Alan-Baylis/robot-electronics/README.md

# robot-electronics
Boards, schematics, reference docs, etc
