Alan-Baylis/robot-electronics/gripper/NOTES.MD

Files in this repo:
* GripperController.dch = DipTrace schematic for GripperController PCB
* GripperController.pdf = PDF of schematic
* GripperController.dip = DipTrace PCB layout file
* GripperControllerBoM.csv = Bill of Materials for GripperController PCB
* GripperController.ino = Arduino source code for GripperController firmware
* HerkulexT.cpp, HerkulexT.h = Arduino library for Herkulex servo, customized (place in same directory as .ino file)
