Alan-Baylis/robot-electronics/System Diagram 003.pdf

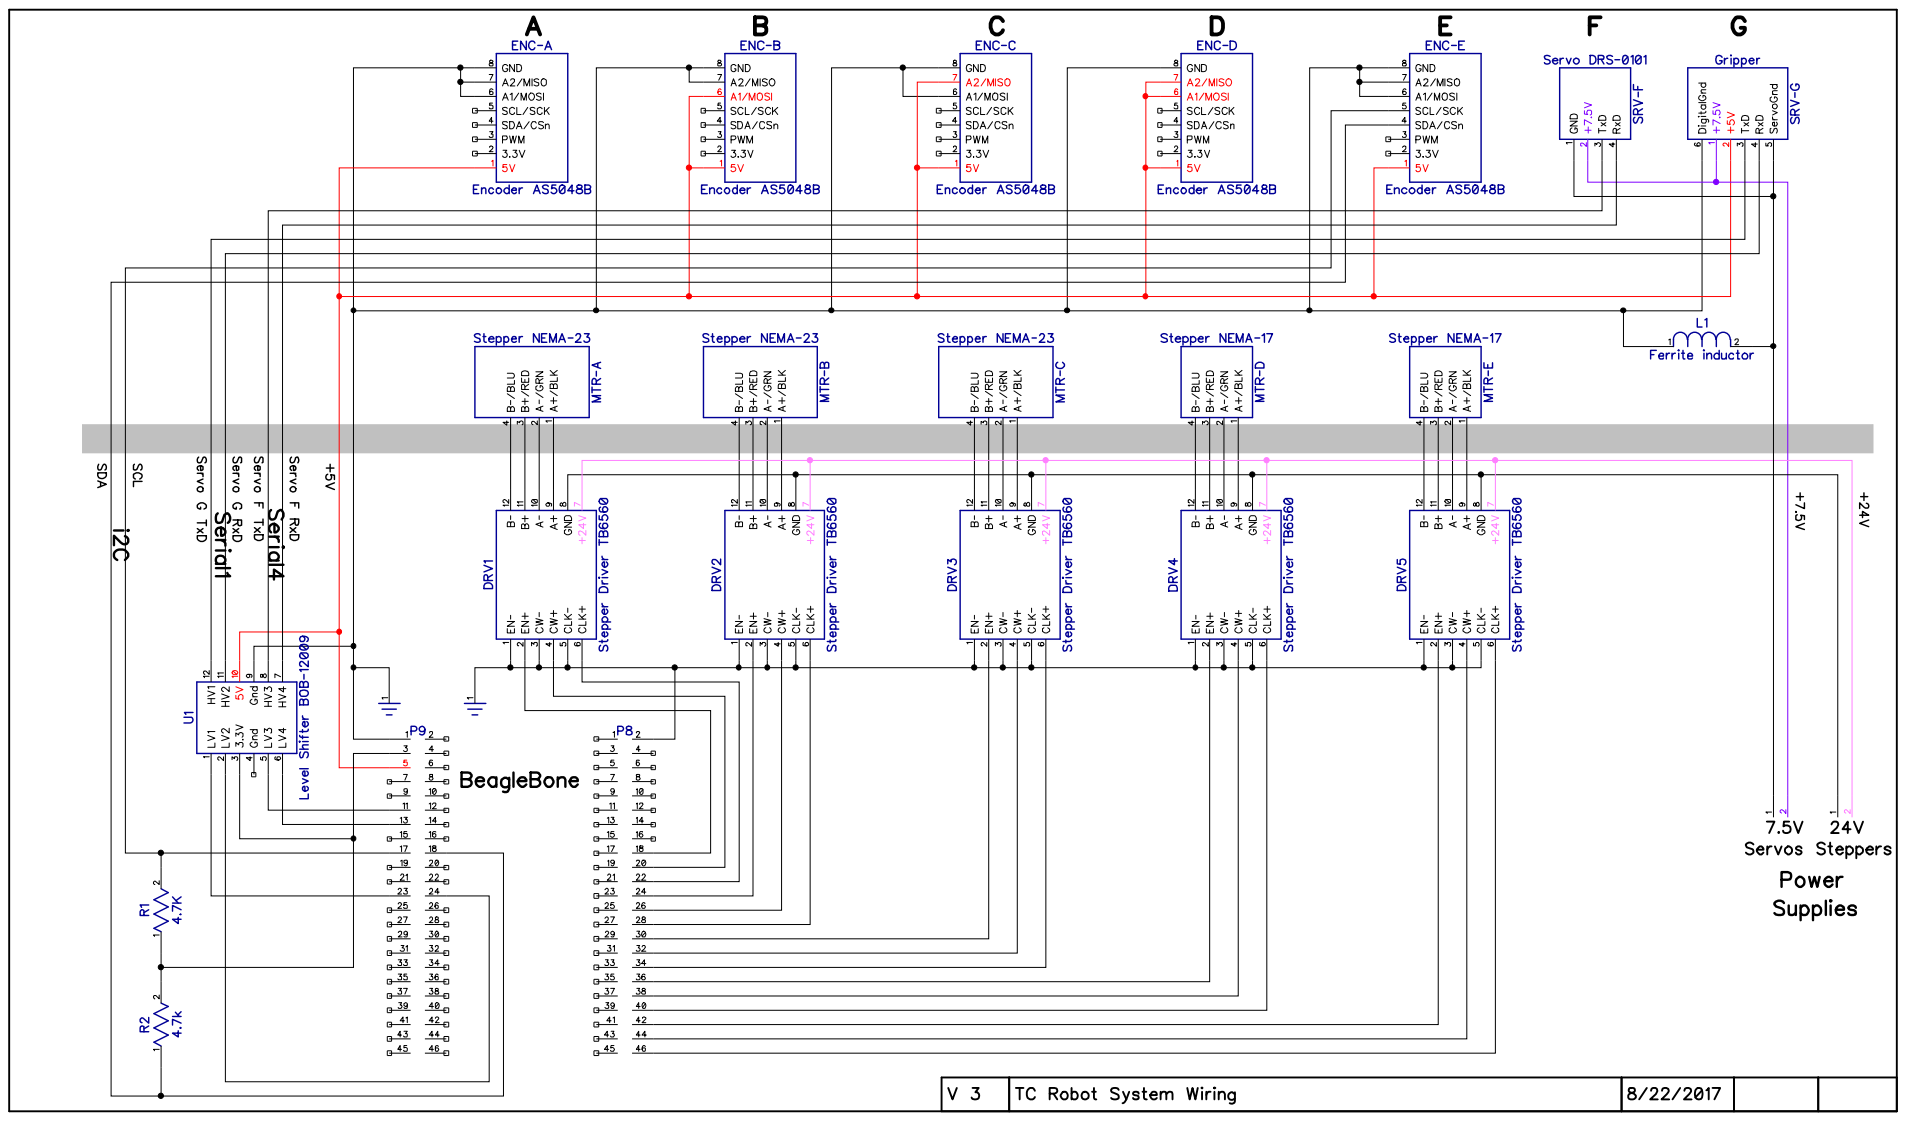
[picture p1: page 1]
