Alan-Baylis/robot-electronics/gripper/GripperController.pdf

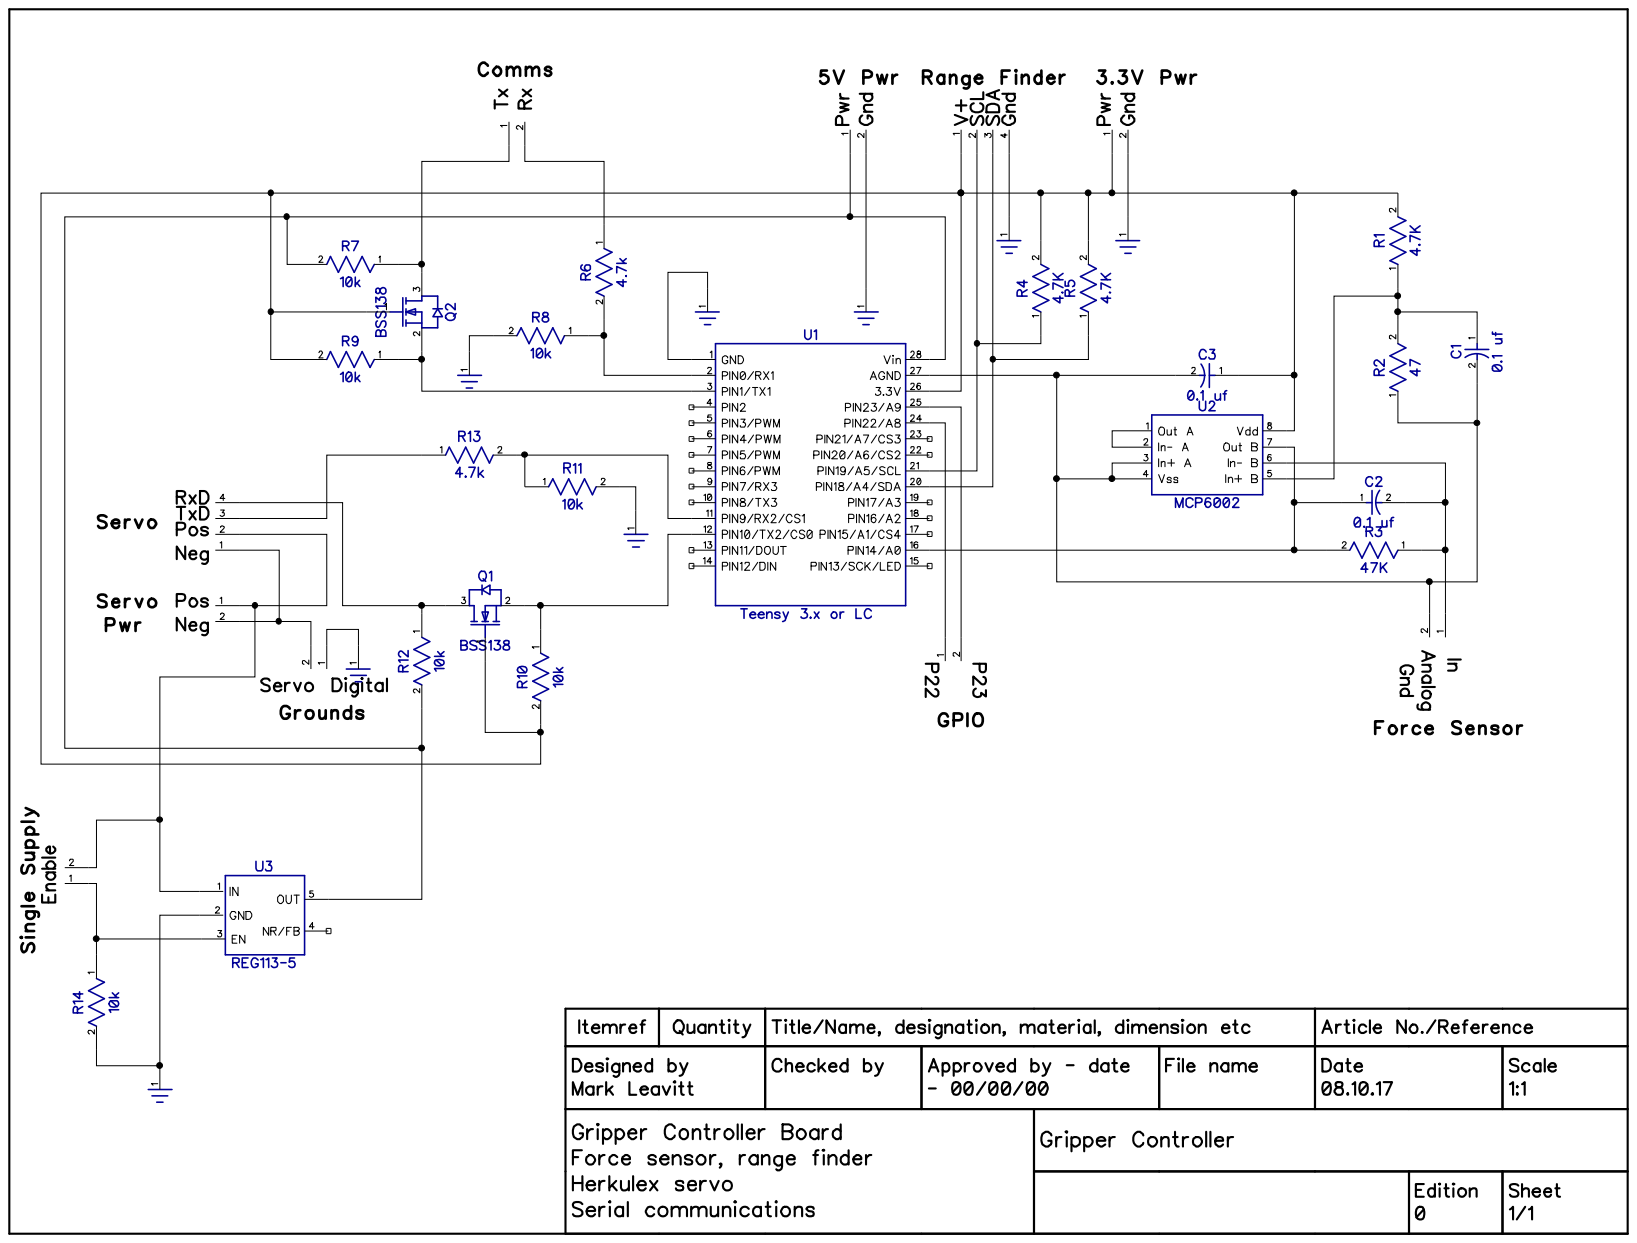
[picture p2: page 1]
