Alan-Baylis/robot-electronics/(list of files, drawings)

Other design files:
gripper/GripperController.dch
gripper/GripperController.dip
System Diagram 003.dch
