Alan-Baylis/robot-electronics/gripper/GripperController/HerkulexT.cpp

/*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
 */
#include "HerkulexT.h"

// Macro for Serial port selection
#define HSerial1     1 		// Write in Serial 1 port Teensy - Pin 0(Rx) - 1 (Tx) 
#define HSerial2     2   	// Write in Serial 2 port Teensy - Pin 9(Rx) - 10 (Tx) 
#define HSerial3     3   	// Write in Serial 3 port Teensy - Pin 7(Rx) - 8 (Tx)
 
// Only allow instantiation only if this is a Teensy 3.x
#if defined(__MK20DX128__) || defined(__MK20DX256__) || defined(__MKL26Z64__) || \
    defined(__MK64FX512__) || defined(__MK66FX1M0__) // 3.0/3.1-3.2/LC/3.5/3.6

// HerkulexT begin with Teensy - Serial 1
void HerkulexTClass::beginSerial1(long baud)
{
	Serial1.begin(baud);
	port = HSerial1;
}

// HerkulexT begin with Teensy - Serial 2
void HerkulexTClass::beginSerial2(long baud)
{
	Serial2.begin(baud);
	port=HSerial2;
}

// HerkulexT begin with Teensy - Serial 3
void HerkulexTClass::beginSerial3(long baud)
{
	Serial3.begin(baud);
	port = HSerial3;
}
#endif

// HerkulexT end
void HerkulexTClass::end()
{
	switch (port)
	{
	case HSerial1:
		Serial1.end();
		break;
	case HSerial2:
		Serial2.end();
		break;
	case HSerial3:
		Serial3.end();
		break;
	//#endif
	}
}

// initialize servos
void HerkulexTClass::initialize()
{
        conta=0;
		lengthString=0;
        delay(100);       
        clearError(BROADCAST_ID);	// clear error for all servos
        delay(10);
        ACK(1);						// set ACK
        delay(10);
        torqueON(BROADCAST_ID);		// torqueON for all servos
        delay(10);
}

// stat
byte HerkulexTClass::stat(int servoID)
{
	{
	pSize    = 0x07;			//3.Packet size
	pID      = servoID;			//4.Servo ID - 0XFE=All servos
	cmd      = HSTAT;			//5.CMD
	
	ck1=(pSize^pID^cmd)&0xFE;
        ck2=(~(pSize^pID^cmd))&0xFE ; 
  
	dataEx[0] = 0xFF;			// Packet Header
	dataEx[1] = 0xFF;			// Packet Header	
	dataEx[2] = pSize;	 		// Packet Size
	dataEx[3] = pID;			// Servo ID
	dataEx[4] = cmd;			// Command Ram Write
	dataEx[5] = ck1;			// Checksum 1
	dataEx[6] = ck2;			// Checksum 2
	     
	sendData(dataEx, pSize);
	delay(2);
	readData(9); 				// read 9 bytes from serial

	
	pSize = dataEx[2];           // 3.Packet size 7-58
	pID   = dataEx[3];           // 4. Servo ID
	cmd   = dataEx[4];           // 5. CMD
	data[0]=dataEx[7];
    data[1]=dataEx[8];
    lengthString=2;

	
    ck1 = (dataEx[2]^dataEx[3]^dataEx[4]^dataEx[7]^dataEx[8]) & 0xFE;
	ck2=checksum2(ck1);			
	
	if (ck1 != dataEx[5]) return -1; //checksum verify
	if (ck2 != dataEx[6]) return -2;

	return dataEx[7];			// return status
}
}

// torque on - 
void HerkulexTClass::torqueON(int servoID)
{
	pSize = 0x0A;               // 3.Packet size 7-58
	pID   = servoID;            // 4. Servo ID
	cmd   = HRAMWRITE;          // 5. CMD
	data[0]=0x34;               // 8. Address
	data[1]=0x01;               // 9. length
	data[2]=0x60;               // 10. 0x60=Torque ON
	lengthString=3;             // lengthData
  	
	ck1=checksum1(data,lengthString);	//6. Checksum1
	ck2=checksum2(ck1);					//7. Checksum2

	dataEx[0] = 0xFF;			// Packet Header
	dataEx[1] = 0xFF;			// Packet Header	
	dataEx[2] = pSize;	 		// Packet Size
	dataEx[3] = pID;			// Servo ID
	dataEx[4] = cmd;			// Command Ram Write
	dataEx[5] = ck1;			// Checksum 1
	dataEx[6] = ck2;			// Checksum 2
	dataEx[7] = data[0]; 		// Address 52
	dataEx[8] = data[1]; 		// Length
	dataEx[9] = data[2]; 		// Torque ON

	sendData(dataEx, pSize);
}

// torque off - the torque is FREE, not Break
void HerkulexTClass::torqueOFF(int servoID)
{
	pSize = 0x0A;               // 3.Packet size 7-58
	pID   = servoID;            // 4. Servo ID
	cmd   = HRAMWRITE;          // 5. CMD
	data[0]=0x34;               // 8. Address
	data[1]=0x01;               // 9. length
	data[2]=0x00;               // 10. 0x00=Torque Free
	lengthString=3;             // lengthData
  	
	ck1=checksum1(data,lengthString);	//6. Checksum1
	ck2=checksum2(ck1);					//7. Checksum2

	dataEx[0] = 0xFF;			// Packet Header
	dataEx[1] = 0xFF;			// Packet Header	
	dataEx[2] = pSize;	 		// Packet Size
	dataEx[3] = pID;			// Servo ID
	dataEx[4] = cmd;			// Command Ram Write
	dataEx[5] = ck1;			// Checksum 1
	dataEx[6] = ck2;			// Checksum 2
	dataEx[7] = data[0]; 		// Address 52
	dataEx[8] = data[1]; 		// Length
	dataEx[9] = data[2]; 		// Torque Free

    sendData(dataEx, pSize);

}

// ACK  - 0=No Replay, 1=Only reply to READ CMD, 2=Always reply
void HerkulexTClass::ACK(int valueACK)
{
	pSize = 0x0A;               // 3.Packet size 7-58
	pID   = 0xFE;	            // 4. Servo ID
	cmd   = HRAMWRITE;          // 5. CMD
	data[0]=0x34;               // 8. Address
	data[1]=0x01;               // 9. length
	data[2]=valueACK;           // 10.Value. 0=No Replay, 1=Only reply to READ CMD, 2=Always reply
	lengthString=3;             // lengthData
  	
	ck1=checksum1(data,lengthString);	//6. Checksum1
	ck2=checksum2(ck1);					//7. Checksum2

	dataEx[0] = 0xFF;			// Packet Header
	dataEx[1] = 0xFF;			// Packet Header	
	dataEx[2] = pSize;	 		// Packet Size
	dataEx[3] = pID;			// Servo ID
	dataEx[4] = cmd;			// Command Ram Write
	dataEx[5] = ck1;			// Checksum 1
	dataEx[6] = ck2;			// Checksum 2
	dataEx[7] = data[0]; 		// Address 52
	dataEx[8] = data[1]; 		// Length
	dataEx[9] = data[2]; 		// Value

 	sendData(dataEx, pSize);
}

// model - 1=0101 - 2=0201
byte HerkulexTClass::model()
{
	pSize = 0x09;               // 3.Packet size 7-58
	pID   = 0xFE;	            // 4. Servo ID
	cmd   = HEEPREAD;           // 5. CMD
	data[0]=0x00;               // 8. Address
	data[1]=0x01;               // 9. length
	lengthString=2;             // lengthData
  	
	ck1=checksum1(data,lengthString);	//6. Checksum1
	ck2=checksum2(ck1);					//7. Checksum2

	dataEx[0] = 0xFF;			// Packet Header
	dataEx[1] = 0xFF;			// Packet Header	
	dataEx[2] = pSize;	 		// Packet Size
	dataEx[3] = pID;			// Servo ID
	dataEx[4] = cmd;			// Command Ram Write
	dataEx[5] = ck1;			// Checksum 1
	dataEx[6] = ck2;			// Checksum 2
	dataEx[7] = data[0]; 		// Address
	dataEx[8] = data[1]; 		// Length

    sendData(dataEx, pSize);

	delay(1);
	readData(9);
	
	pSize = dataEx[2];           // 3.Packet size 7-58
	pID   = dataEx[3];           // 4. Servo ID
	cmd   = dataEx[4];           // 5. CMD
	data[0]=dataEx[7];           // 8. 1st byte
	lengthString=1;              // lengthData
  	
	ck1=checksum1(data,lengthString);	//6. Checksum1
	ck2=checksum2(ck1);					//7. Checksum2

	if (ck1 != dataEx[5]) return -1; //checksum verify
	if (ck2 != dataEx[6]) return -2;
		
	return dataEx[7];			// return status

}

// setID - Need to restart the servo
void HerkulexTClass::set_ID(int ID_Old, int ID_New)
{
	pSize = 0x0A;               // 3.Packet size 7-58
	pID   = ID_Old;		        // 4. Servo ID OLD - original servo ID
	cmd   = HEEPWRITE;          // 5. CMD
	data[0]=0x06;               // 8. Address
	data[1]=0x01;               // 9. length
	data[2]=ID_New;             // 10. ServoID NEW
	lengthString=3;             // lengthData
  	
	ck1=checksum1(data,lengthString);	//6. Checksum1
	ck2=checksum2(ck1);					//7. Checksum2

	dataEx[0] = 0xFF;			// Packet Header
	dataEx[1] = 0xFF;			// Packet Header	
	dataEx[2] = pSize;	 		// Packet Size
	dataEx[3] = pID;			// Servo ID
	dataEx[4] = cmd;			// Command Ram Write
	dataEx[5] = ck1;			// Checksum 1
	dataEx[6] = ck2;			// Checksum 2
	dataEx[7] = data[0]; 		// Address 52
	dataEx[8] = data[1]; 		// Length
	dataEx[9] = data[2]; 		// Value

	sendData(dataEx, pSize);

}

// clearError
void HerkulexTClass::clearError(int servoID)
{
	pSize = 0x0B;               // 3.Packet size 7-58
	pID   = servoID;     		// 4. Servo ID - 253=all servos
	cmd   = HRAMWRITE;          // 5. CMD
	data[0]=0x30;               // 8. Address
	data[1]=0x02;               // 9. length
	data[2]=0x00;               // 10. Write error=0
	data[3]=0x00;               // 10. Write detail error=0
	
	lengthString=4;             // lengthData
  	
	ck1=checksum1(data,lengthString);	//6. Checksum1
	ck2=checksum2(ck1);					//7. Checksum2

	dataEx[0] = 0xFF;			// Packet Header
	dataEx[1] = 0xFF;			// Packet Header	
	dataEx[2] = pSize;	 		// Packet Size
	dataEx[3] = pID;			// Servo ID
	dataEx[4] = cmd;			// Command Ram Write
	dataEx[5] = ck1;			// Checksum 1
	dataEx[6] = ck2;			// Checksum 2
	dataEx[7] = data[0]; 		// Address 52
	dataEx[8] = data[1]; 		// Length
	dataEx[9] = data[2]; 		// Value1
	dataEx[10]= data[3]; 		// Value2

	sendData(dataEx, pSize);
}

// move all servo at the same time to a position: servo list building
void HerkulexTClass::moveAll(int servoID, int Goal, int iLed)
{
	  if (Goal > 1023 || Goal < 0)
		return;						 //0 <--> 1023 range
	  
	  int iMode=0;                   //mode=position
	  int iStop=0;                   //stop=0
	  

	  // Position definition
	  int posLSB=Goal & 0X00FF;					// MSB Pos
	  int posMSB=(Goal & 0XFF00) >> 8;			// LSB Pos

	  //led 
	  int iBlue=0;
	  int iGreen=0;
	  int iRed=0;
	  switch (iLed) {
	  case 1:
		iGreen=1;
		break;
	  case 2:
		iBlue=1;
		break;
	  case 3:
		iRed=1;
		break;
	  }
	  
	  int SetValue=iStop+iMode*2+iGreen*4+iBlue*8+iRed*16;	//assign led value

	  addData(posLSB, posMSB, SetValue, servoID);	//add servo data to list, pos mode
}

// move all servo at the same time to a position: servo list building
void HerkulexTClass::moveAllAngle(int servoID, float angle, int iLed)
{
		if (angle > 160.0|| angle < -160.0) return; // out of the range	
		int position = (int)(angle/0.325) + 512;
		moveAll(servoID, position, iLed);
}



// move all servo at the same time with different speeds: servo list building
void HerkulexTClass::moveSpeedAll(int servoID, int Goal, int iLed)
{
	  if (Goal > 1023 || Goal < -1023)
		return;								 //-1023 <--> 1023 range

	  int iMode=1;                  		// mode=continous rotation
	  int iStop=0;                  		// Stop=0

	  // Speed definition
	  int GoalSpeedSign;
	  if (Goal < 0) {
		GoalSpeedSign = (-1)* Goal ;
		GoalSpeedSign |= 0x4000;  //bit n°14 
	  } 
	  else {
		GoalSpeedSign = Goal;
	  }

	  int speedGoalLSB=GoalSpeedSign & 0X00FF; 	      		 // MSB speedGoal 
	  int speedGoalMSB=(GoalSpeedSign & 0xFF00) >> 8;        // LSB speedGoal 

	  //led 
	  int iBlue=0;
	  int iGreen=0;
	  int iRed=0;
	  switch (iLed) {
	  case 1:
		iGreen=1;
		break;
	  case 2:
		iBlue=1;
		break;
	  case 3:
		iRed=1;
		break;
	  }

	  int SetValue=iStop+iMode*2+iGreen*4+iBlue*8+iRed*16;	//assign led value

	  addData(speedGoalLSB, speedGoalMSB, SetValue, servoID);		//add servo data to list, speed mode
}



// move all servo with the same execution time
void HerkulexTClass::actionAll(int pTime)
{
	if ((pTime <0) || (pTime > 2856)) return;

    pSize = 0x08 + conta;     	    // 3.Packet size 7-58
	cmd   = HSJOG;		 			// 5. CMD SJOG Write n servo with same execution time
	playTime=int((float)pTime/11.2);// 8. Execution time
 
    pID=0xFE^playTime;
    ck1=checksum1(moveData,conta);	//6. Checksum1
	ck2=checksum2(ck1);				//7. Checksum2

    pID=0xFE;
	dataEx[0] = 0xFF;				// Packet Header
	dataEx[1] = 0xFF;				// Packet Header	
	dataEx[2] = pSize;	 			// Packet Size
	dataEx[3] = pID;				// Servo ID
	dataEx[4] = cmd;				// Command Ram Write
	dataEx[5] = ck1;				// Checksum 1
	dataEx[6] = ck2;				// Checksum 2
	dataEx[7] = playTime;			// Execution time	
	
	for (int i=0; i < conta; i++)
		dataEx[i+8]=moveData[i];	// Variable servo data

	sendData(dataEx, pSize);

	conta=0; 						//reset counter   

}

// get Position
 int HerkulexTClass::getPosition(int servoID) {
	int Position  = 0;

    pSize = 0x09;               // 3.Packet size 7-58
	pID   = servoID;     	    // 4. Servo ID - 253=all servos
	cmd   = HRAMREAD;           // 5. CMD
	data[0]=0x3A;               // 8. Address
	data[1]=0x02;               // 9. length
	
	lengthString=2;             // lengthData
  	
	ck1=checksum1(data,lengthString);	//6. Checksum1
	ck2=checksum2(ck1);					//7. Checksum2

	dataEx[0] = 0xFF;			// Packet Header
	dataEx[1] = 0xFF;			// Packet Header	
	dataEx[2] = pSize;	 		// Packet Size
	dataEx[3] = pID;			// Servo ID
	dataEx[4] = cmd;			// Command Ram Write
	dataEx[5] = ck1;			// Checksum 1
	dataEx[6] = ck2;			// Checksum 2
	dataEx[7] = data[0];      	// Address  
	dataEx[8] = data[1]; 		// Length
	
	sendData(dataEx, pSize);

    delay(1);
	readData(13);

        	
	pSize = dataEx[2];           // 3.Packet size 7-58
	pID   = dataEx[3];           // 4. Servo ID
	cmd   = dataEx[4];           // 5. CMD
	data[0]=dataEx[7];
    data[1]=dataEx[8];
    data[2]=dataEx[9];
    data[3]=dataEx[10];
    data[4]=dataEx[11];
    data[5]=dataEx[12];
    lengthString=6;

    ck1=checksum1(data,lengthString);	//6. Checksum1
	ck2=checksum2(ck1);					//7. Checksum2

    if (ck1 != dataEx[5]) return -1;
	if (ck2 != dataEx[6]) return -1;

	Position = ((dataEx[10]&0x03)<<8) | dataEx[9];
        return Position;
	
}

float HerkulexTClass::getAngle(int servoID) {
	int pos = (int)getPosition(servoID);
	return (pos-512) * 0.325;
}

// rollback servo to default settings
void HerkulexTClass::rollback(int servoID) {
        
    pSize = 0x07;               // 3.Packet size 7-58
	pID   = servoID;     	    // 4. Servo ID - 253=all servos
	cmd   = HROLLBACK;          // 5. CMD
    ck1=(pSize^pID^cmd)&0xFE;
    ck2=(~(pSize^pID^cmd))&0xFE ; ;	

	dataEx[0] = 0xFF;			// Packet Header
	dataEx[1] = 0xFF;			// Packet Header	
	dataEx[2] = pSize;	 		// Packet Size
	dataEx[3] = pID;			// Servo ID
	dataEx[4] = cmd;			// Command Ram Write
	dataEx[5] = ck1;			// Checksum 1
	dataEx[6] = ck2;			// Checksum 2
	
	sendData(dataEx, pSize);

}// reboot single servo - pay attention 253 - all servos doesn't work!
void HerkulexTClass::reboot(int servoID) {
        
    pSize = 0x07;               // 3.Packet size 7-58
	pID   = servoID;     	    // 4. Servo ID - 253=all servos
	cmd   = HREBOOT;            // 5. CMD
    ck1=(pSize^pID^cmd)&0xFE;
    ck2=(~(pSize^pID^cmd))&0xFE ; ;	

	dataEx[0] = 0xFF;			// Packet Header
	dataEx[1] = 0xFF;			// Packet Header	
	dataEx[2] = pSize;	 		// Packet Size
	dataEx[3] = pID;			// Servo ID
	dataEx[4] = cmd;			// Command Ram Write
	dataEx[5] = ck1;			// Checksum 1
	dataEx[6] = ck2;			// Checksum 2
	
	sendData(dataEx, pSize);

}

// LED  - see table of colors 
void HerkulexTClass::setLed(int servoID, int valueLed)
{
	pSize   = 0x0A;               // 3.Packet size 7-58
	pID     = servoID;            // 4. Servo ID
	cmd     = HRAMWRITE;          // 5. CMD
	data[0] = 0x35;               // 8. Address 53
    data[1] = 0x01;               // 9. length
	data[2] = valueLed;           // 10.LedValue
	lengthString=3;               // lengthData
  	  	
	ck1=checksum1(data,lengthString);	//6. Checksum1
	ck2=checksum2(ck1);					//7. Checksum2

	dataEx[0] = 0xFF;			// Packet Header
	dataEx[1] = 0xFF;			// Packet Header	
	dataEx[2] = pSize;	 		// Packet Size
	dataEx[3] = pID;			// Servo ID
	dataEx[4] = cmd;			// Command Ram Write
	dataEx[5] = ck1;			// Checksum 1
	dataEx[6] = ck2;			// Checksum 2
	dataEx[7] = data[0];        // Address
	dataEx[8] = data[1];       	// Length
	dataEx[9] = data[2];        // Value

	sendData(dataEx, pSize);
}

// get the speed for one servo - values betweeb -1023 <--> 1023
int HerkulexTClass::getSpeed(int servoID) {
  int speedy  = 0;

  pSize = 0x09;               // 3.Packet size 7-58
  pID   = servoID;     	   	  // 4. Servo ID 
  cmd   = HRAMREAD;           // 5. CMD
  data[0]=0x40;               // 8. Address
  data[1]=0x02;               // 9. length

  lengthString=2;             // lengthData

  ck1=checksum1(data,lengthString);		//6. Checksum1
  ck2=checksum2(ck1);					//7. Checksum2

  dataEx[0] = 0xFF;			// Packet Header
  dataEx[1] = 0xFF;			// Packet Header	
  dataEx[2] = pSize;		// Packet Size
  dataEx[3] = pID;			// Servo ID
  dataEx[4] = cmd;			// Command Ram Write
  dataEx[5] = ck1;			// Checksum 1
  dataEx[6] = ck2;			// Checksum 2
  dataEx[7] = data[0]; 	    // Address  
  dataEx[8] = data[1]; 		// Length

  sendData(dataEx, pSize);

  delay(1);
  readData(13);


  pSize = dataEx[2];           // 3.Packet size 7-58
  pID   = dataEx[3];           // 4. Servo ID
  cmd   = dataEx[4];           // 5. CMD
  data[0]=dataEx[7];
  data[1]=dataEx[8];
  data[2]=dataEx[9];
  data[3]=dataEx[10];
  data[4]=dataEx[11];
  data[5]=dataEx[12];
  lengthString=6;

  ck1=checksum1(data,lengthString);	//6. Checksum1
  ck2=checksum2(ck1);				//7. Checksum2

  if (ck1 != dataEx[5]) return -1;
  if (ck2 != dataEx[6]) return -1;

  speedy = ((dataEx[10]&0xFF)<<8) | dataEx[9];
  return speedy;

}



// move one servo with continous rotation
void HerkulexTClass::moveSpeedOne(int servoID, int Goal, int pTime, int iLed)
{
  if (Goal > 1023 || Goal < -1023) return;              // speed (goal) non correct
  if ((pTime <0) || (pTime > 2856)) return;

  int GoalSpeedSign;
  if (Goal < 0) {
    GoalSpeedSign = (-1)* Goal ;
    GoalSpeedSign |= 0x4000;  //bit n°14 
  } 
  else {
    GoalSpeedSign = Goal;
  }
  int speedGoalLSB=GoalSpeedSign & 0X00FF; 		       // MSB speedGoal 
  int speedGoalMSB=(GoalSpeedSign & 0xFF00) >> 8;      // LSB speedGoal 

  //led 
  int iBlue=0;
  int iGreen=0;
  int iRed=0;
  switch (iLed) {
  case 1:
    iGreen=1;
    break;
  case 2:
    iBlue=1;
    break;
  case 3:
    iRed=1;
    break;
  }
  int SetValue=2+iGreen*4+iBlue*8+iRed*16;		//assign led value 

  playTime=int((float)pTime/11.2);				// 8. Execution time

  pSize = 0x0C;              					// 3.Packet size 7-58
  cmd   = HSJOG;      					        // 5. CMD

  data[0]=speedGoalLSB;            			    // 8. speedLSB
  data[1]=speedGoalMSB;              			// 9. speedMSB
  data[2]=SetValue;                          	// 10. Mode=0;
  data[3]=servoID;                    			// 11. ServoID

  pID=servoID^playTime;

  lengthString=4;             					// lengthData

  ck1=checksum1(data,lengthString);				//6. Checksum1
  ck2=checksum2(ck1);							//7. Checksum2

  pID=servoID;

  dataEx[0] = 0xFF;				// Packet Header
  dataEx[1] = 0xFF;				// Packet Header	
  dataEx[2] = pSize;	 		// Packet Size
  dataEx[3] = pID;				// Servo ID
  dataEx[4] = cmd;				// Command Ram Write
  dataEx[5] = ck1;				// Checksum 1
  dataEx[6] = ck2;				// Checksum 2
  dataEx[7] = playTime;  		// Execution time	
  dataEx[8] = data[0];
  dataEx[9] = data[1];
  dataEx[10] = data[2];
  dataEx[11] = data[3];
  
  sendData(dataEx, pSize);

}

// move one servo at goal position 0 - 1024
void HerkulexTClass::moveOne(int servoID, int Goal, int pTime, int iLed)
{
  if (Goal > 1023 || Goal < 0) return;              // speed (goal) non correct
  if ((pTime <0) || (pTime > 2856)) return;

  // Position definition
  int posLSB=Goal & 0X00FF;								// MSB Pos
  int posMSB=(Goal & 0XFF00) >> 8;						// LSB Pos

  //led 
  int iBlue=0;
  int iGreen=0;
  int iRed=0;
  switch (iLed) {
  case 1:
    iGreen=1;
    break;
  case 2:
    iBlue=1;
    break;
  case 3:
    iRed=1;
    break;
  }
  int SetValue=iGreen*4+iBlue*8+iRed*16;	//assign led value 

  playTime=int((float)pTime/11.2);			// 8. Execution time

  pSize = 0x0C;          			    	// 3.Packet size 7-58
  cmd   = HSJOG;              				// 5. CMD

  data[0]=posLSB;               			// 8. speedLSB
  data[1]=posMSB;               			// 9. speedMSB
  data[2]=SetValue;                         // 10. Mode=0;
  data[3]=servoID;                    		// 11. ServoID

    pID=servoID^playTime;

  lengthString=4;             				// lengthData

  ck1=checksum1(data,lengthString);			//6. Checksum1
  ck2=checksum2(ck1);						//7. Checksum2

  pID=servoID;

  dataEx[0] = 0xFF;				// Packet Header
  dataEx[1] = 0xFF;				// Packet Header	
  dataEx[2] = pSize;	 		// Packet Size
  dataEx[3] = pID;				// Servo ID
  dataEx[4] = cmd;				// Command Ram Write
  dataEx[5] = ck1;				// Checksum 1
  dataEx[6] = ck2;				// Checksum 2
  dataEx[7] = playTime;  		// Execution time	
  dataEx[8] = data[0];
  dataEx[9] = data[1];
  dataEx[10] = data[2];
  dataEx[11] = data[3];

  sendData(dataEx, pSize);

}

// move one servo to an angle between -160 and 160
void HerkulexTClass::moveOneAngle(int servoID, float angle, int pTime, int iLed) {
	if (angle > 160.0|| angle < -160.0) return;	
	int position = (int)(angle/0.325) + 512;
	moveOne(servoID, position, pTime, iLed);
}

// write registry in the RAM: one byte 
void HerkulexTClass::writeRegistryRAM(int servoID, int address, int writeByte)
{
  pSize = 0x0A;               	// 3.Packet size 7-58
  pID   = servoID;     			// 4. Servo ID - 253=all servos
  cmd   = HRAMWRITE;          	// 5. CMD
  data[0]=address;              // 8. Address
  data[1]=0x01;               	// 9. length
  data[2]=writeByte;            // 10. Write error=0
 
  lengthString=3;             	// lengthData

  ck1=checksum1(data,lengthString);	//6. Checksum1
  ck2=checksum2(ck1);				//7. Checksum2

  dataEx[0] = 0xFF;			// Packet Header
  dataEx[1] = 0xFF;			// Packet Header	
  dataEx[2] = pSize;	 	// Packet Size
  dataEx[3] = pID;			// Servo ID
  dataEx[4] = cmd;			// Command Ram Write
  dataEx[5] = ck1;			// Checksum 1
  dataEx[6] = ck2;			// Checksum 2
  dataEx[7] = data[0]; 		// Address 52
  dataEx[8] = data[1]; 		// Length
  dataEx[9] = data[2]; 		// Value1
  dataEx[10]= data[3]; 		// Value2

  sendData(dataEx, pSize);

}

// write registry in the EEP memory (ROM): one byte 
void HerkulexTClass::writeRegistryEEP(int servoID, int address, int writeByte)
{
  pSize = 0x0A;                  // 3.Packet size 7-58
  pID   = servoID;     	         // 4. Servo ID - 253=all servos
  cmd   = HEEPWRITE;             // 5. CMD
  data[0]=address;               // 8. Address
  data[1]=0x01;                  // 9. length
  data[2]=writeByte;             // 10. Write error=0
 
  lengthString=3;           	 // lengthData

  ck1=checksum1(data,lengthString);	//6. Checksum1
  ck2=checksum2(ck1);				//7. Checksum2

  dataEx[0] = 0xFF;			// Packet Header
  dataEx[1] = 0xFF;			// Packet Header	
  dataEx[2] = pSize;		// Packet Size
  dataEx[3] = pID;			// Servo ID
  dataEx[4] = cmd;			// Command Ram Write
  dataEx[5] = ck1;			// Checksum 1
  dataEx[6] = ck2;			// Checksum 2
  dataEx[7] = data[0]; 		// Address 52
  dataEx[8] = data[1]; 		// Length
  dataEx[9] = data[2]; 		// Value1
  dataEx[10]= data[3]; 		// Value2

  sendData(dataEx, pSize);

}



// Private Methods //////////////////////////////////////////////////////////////

// checksum1
int HerkulexTClass::checksum1(byte* data, int lengthString)
{
  XOR = 0;	
  XOR = XOR ^ pSize;
  XOR = XOR ^ pID;
  XOR = XOR ^ cmd;
  for (int i = 0; i < lengthString; i++) 
  {
    XOR = XOR ^ data[i];
  }
  return XOR&0xFE;
}


// checksum2
int HerkulexTClass::checksum2(int XOR)
{
  return (~XOR)&0xFE;
}

// add data to variable list servo for syncro execution
void HerkulexTClass::addData(int GoalLSB, int GoalMSB, int set, int servoID)
{
  moveData[conta++]=GoalLSB;  
  moveData[conta++]=GoalMSB;
  moveData[conta++]=set;
  moveData[conta++]=servoID;
}

// Sending the buffer long length to Serial port
void HerkulexTClass::sendData(byte* buffer, int length)
{
		clearBuffer(); 		//clear the serialport buffer - try to do it!
        switch (port)
		{
			//#if defined (__AVR_ATmega1280__) || defined (__AVR_ATmega128__) || defined (__AVR_ATmega2560__)
			case HSerial1:
				Serial1.write(buffer, length);
				delay(1);
				break;
			case HSerial2:
				Serial2.write(buffer, length);
				delay(1);
				break;
			case HSerial3:
				Serial3.write(buffer, length);
				delay(1);
				break;
			//#endif
		}
}

// * Receiving the length of bytes from Serial port
void HerkulexTClass::readData(int size)
{
	int i = 0;
    int beginsave=0;
    int Time_Counter=0;
    switch (port)
	{
	
	//#if defined (__AVR_ATmega1280__) || defined (__AVR_ATmega128__) || defined (__AVR_ATmega2560__)
	case HSerial1:
		while((Serial1.available() < size) & (Time_Counter < TIME_OUT)){
        		Time_Counter++;
        		delayMicroseconds(1000);
		}      	
		while (Serial1.available() > 0){
      		byte inchar = (byte)Serial1.read();
			//printHexByte(inchar);
        	if ( (inchar == 0xFF) & ((byte)Serial1.peek() == 0xFF) ){
						beginsave=1;
						i=0; 						
             }
            if (beginsave==1 && i<size) {
                       dataEx[i] = inchar;
                       i++;
			}
		}
		break;
	
	case HSerial2:
	    while((Serial2.available() < size) & (Time_Counter < TIME_OUT)){
        		Time_Counter++;
        		delayMicroseconds(1000);
		}
        	
		while (Serial2.available() > 0){
			byte inchar = (byte)Serial2.read();
			if ( (inchar == 0xFF) & ((byte)Serial2.peek() == 0xFF) ){
					beginsave=1;
					i=0; 					
			}
			if (beginsave==1 && i<size) {
				   dataEx[i] = inchar;
				   i++;
			}
		}
		break;

	case HSerial3:
		while((Serial3.available() < size) & (Time_Counter < TIME_OUT)){
			Time_Counter++;
			delayMicroseconds(1000);
		}
		
		while (Serial3.available() > 0){
			byte inchar = (byte)Serial3.read();
			if ( (inchar == 0xFF) & ((byte)Serial3.peek() == 0xFF) ){
					beginsave=1;
					i=0; 
			}
			if (beginsave==1 && i<size) {
				   dataEx[i] = inchar;
				   i++;
			}
		}
		break;
	//#endif
	}
}

//clear buffer in the serial port - better - try to do this
void HerkulexTClass::clearBuffer()
{
  switch (port)
	{
	//#if defined (__AVR_ATmega1280__) || defined (__AVR_ATmega128__) || defined (__AVR_ATmega2560__)
	case HSerial1:
				Serial1.flush();
				while (Serial1.available()){
				Serial1.read();
				delayMicroseconds(200);
				}

		break;
	case HSerial2:
	            Serial2.flush();
				while (Serial2.available()){
				Serial2.read();
				delayMicroseconds(200);
				}
		break;
	case HSerial3:
	            Serial3.flush();
				while (Serial3.available()){
					Serial3.read();
					delayMicroseconds(200);
				}

		break;
	//#endif
	}
}

void HerkulexTClass::printHexByte(byte x)
{
  Serial.print("0x");
  if (x < 16) {
    Serial.print('0');
  }
    Serial.print(x, HEX);
    Serial.print(" ");

}



 HerkulexTClass HerkulexT;
