Alan-Baylis/robot-electronics/gripper/GripperController/HerkulexT.h

/*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
	 You should have received a copy of the GNU Lesser General Public
	 License along with this library; if not, write to the Free Software
	 Foundation, Inc., 51 Franklin St, Fifth Floor, Boston, MA  02110-1301  USA
*/

#ifndef HerkulexT_h
#define HerkulexT_h
#include "Arduino.h"

#define DATA_SIZE	 30		// buffer for input data
#define DATA_MOVE  	 50		// max 10 servos <---- change this for more servos!
#define TIME_OUT     5   	//timeout serial communication

// SERVO HERKULEX COMMAND - See Manual p40
#define HEEPWRITE    0x01 	//Rom write
#define HEEPREAD     0x02 	//Rom read
#define HRAMWRITE	 0x03 	//Ram write
#define HRAMREAD	 0x04 	//Ram read
#define HIJOG		 0x05 	//Write n servo position or angle
#define HSJOG		 0x06 	//Write n servo speed (continuous rotation)
#define HSTAT	 	 0x07 	//Request status
#define HROLLBACK	 0x08 	//Roll back to factory values, except ID and baud rate
#define HREBOOT	 	 0x09 	//Reboot

// HERKULEX LED - See Manual p29
#define H_LED_OFF		0x00
#define H_LED_GREEN		0x01
#define H_LED_BLUE		0x02
#define H_LED_CYAN		0x03
#define H_LED_RED		0x04
#define H_LED_YELLOW	0x05
#define H_LED_PURPLE	0x06
#define H_LED_WHITE		0x07

// HERKULEX STATUS ERROR - See Manual p39
#define H_STATUS_OK					0x00
#define H_ERROR_INPUT_VOLTAGE 		0x01
#define H_ERROR_POS_LIMIT			0x02
#define H_ERROR_TEMPERATURE_LIMIT	0x04
#define H_ERROR_INVALID_PKT			0x08
#define H_ERROR_OVERLOAD			0x10
#define H_ERROR_DRIVER_FAULT  		0x20
#define H_ERROR_EEPREG_DISTORT		0x40

// HERKULEX Broadcast Servo ID
#define BROADCAST_ID	0xFE

class HerkulexTClass {
public:
	void  beginSerial1(long baud);
	void  beginSerial2(long baud);
	void  beginSerial3(long baud);
	void  end();
	
	void  initialize();
	byte  stat(int servoID);
	void  ACK(int valueACK);
	byte  model();
	void  set_ID(int ID_Old, int ID_New);
	void  clearError(int servoID);
	
	void  torqueON(int servoID);
	void  torqueOFF(int servoID);
	
	void  moveAll(int servoID, int Goal, int iLed);
	void  moveSpeedAll(int servoID, int Goal, int iLed);
	void  moveAllAngle(int servoID, float angle, int iLed);
	void  actionAll(int pTime);
	
	void  moveSpeedOne(int servoID, int Goal, int pTime, int iLed);
	void  moveOne(int servoID, int Goal, int pTime, int iLed);
	void  moveOneAngle(int servoID, float angle, int pTime, int iLed);
	
	int   getPosition(int servoID);
	float getAngle(int servoID);
	int   getSpeed(int servoID);

	void  rollback(int servoID);
	void  reboot(int servoID);
	void  setLed(int servoID, int valueLed);
 
	void  writeRegistryRAM(int servoID, int address, int writeByte);
	void  writeRegistryEEP(int servoID, int address, int writeByte);
	
private:
	void sendData(byte* buffer, int length);
	void readData(int size);
	void addData(int GoalLSB, int GoalMSB, int set, int servoID);
	int  checksum1(byte* data, int lengthString);
	int  checksum2(int XOR);
	void clearBuffer();
	void printHexByte(byte x);

	int port;
	
	int pSize;
	int pID;
	int cmd;
	int lengthString;
	int ck1;
	int ck2;
	
	int conta;
	
	int XOR;
	int playTime;
		
	byte data[DATA_SIZE]; 
	byte dataEx[DATA_MOVE+8];
	byte moveData[DATA_MOVE];
};

extern HerkulexTClass HerkulexT;

#endif    // HerkulexT_h
