Alan-Baylis/robot-electronics/(commit log)

2017-08-16 Initial commit - schematics for Gripper Controller and TC Robot System Diagram
    [GripperController.dch, System Diagram 002.dch]
2017-08-26 Deleting GripperController.dch - wrong location
    [GripperController.dch]
2017-08-26 Updating system diagram
    [System Diagram 003.dch]
2017-08-26 PCB schematic, layout, and BoM
    [GripperController.dch, GripperController.dip, GripperControllerBoM.csv]
2017-10-13 updated gripper sketch
