Alan-Baylis/robot-electronics/(notices)

Notices in the files:
gripper/GripperController/HerkulexT.cpp:
Copyright (c) 2017 - Mark Leavitt
License:
This library is free software; you can redistribute it and/or
